moritz157/smart-buoy/README.md

# smart-buoy
Ein Jugend forscht Projekt zur Sammlung von Daten zur Gewässerqualität mit dem Ziel der Erforschung von Cyanobakterien.

### How to create the docs
`npm run buildDocs`
or
`apidoc -i ./ -o ./docs -e ./node_modules -e ./docs`
