moritz157/smart-buoy/server/database-design.png

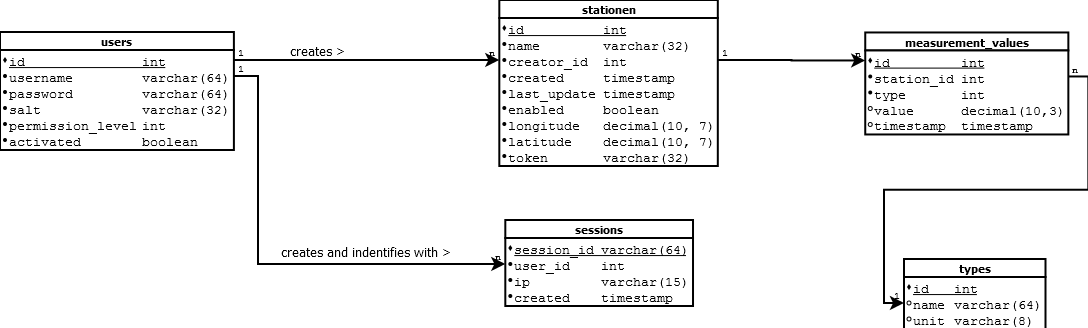
server/database-design.png
