moritz157/smart-buoy/3d models/main_case_main.3mf

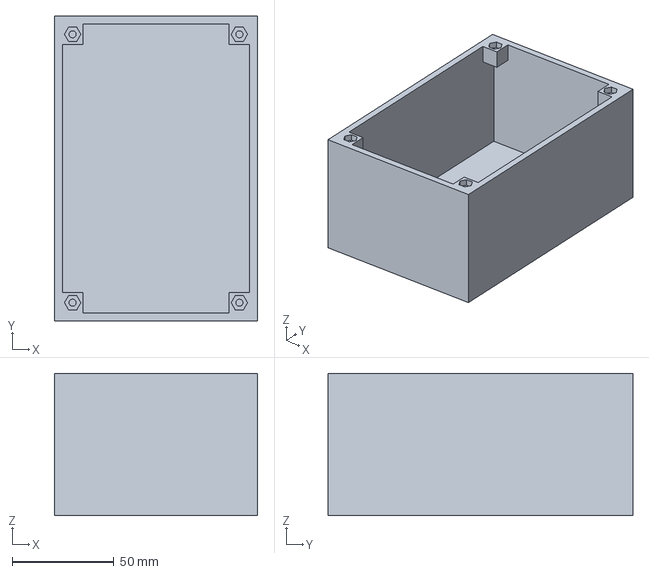
[picture p2: CAD file, 2018-02-24]
3d models/main_case_main.3mf
100.0 x 150.0 x 70.0 mm
