moritz157/smart-buoy/3d models/main_case_top.3mf

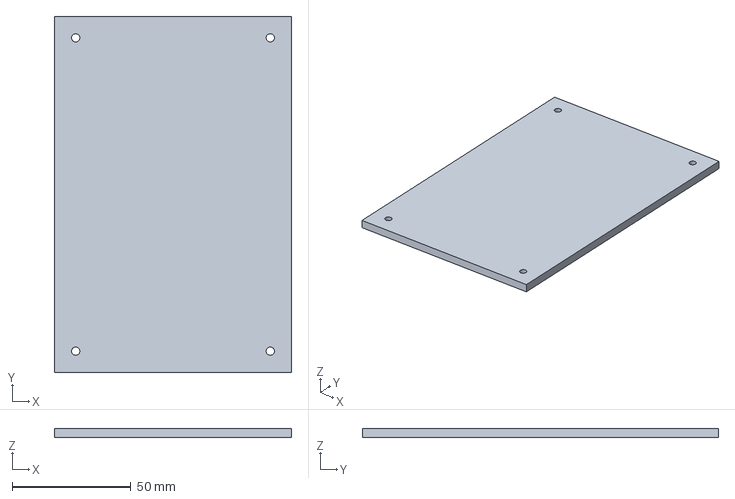
[picture p3: CAD file, 2018-02-24]
3d models/main_case_top.3mf
100.0 x 150.0 x 4.00 mm
