moritz157/smart-buoy/3d models/lamp_plate.stl

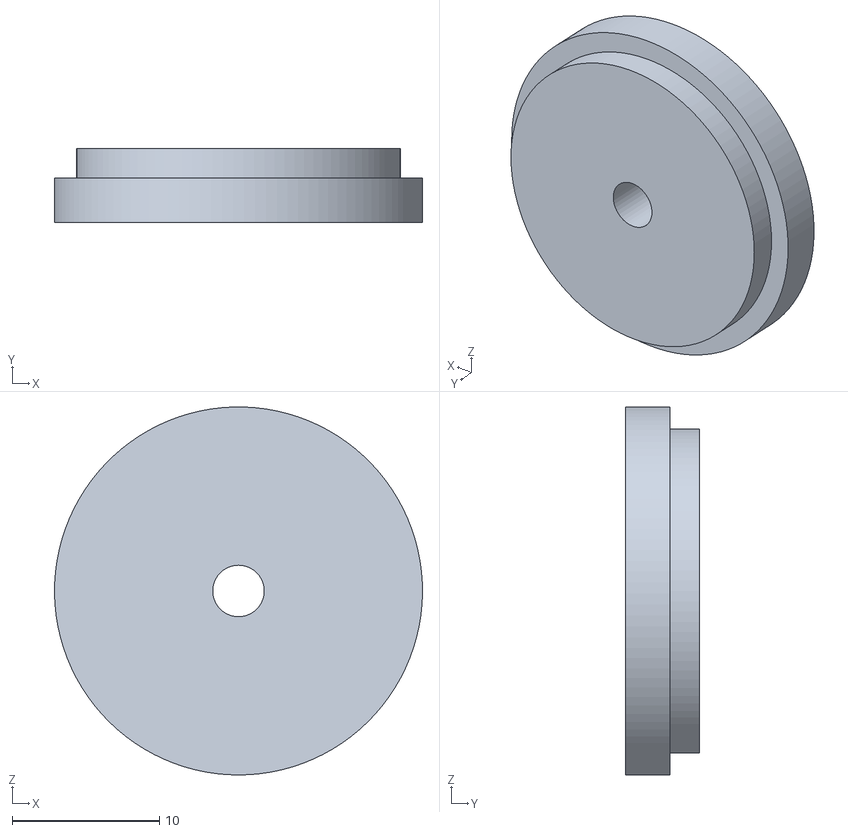
[picture p4: CAD file, 2018-02-27]
3d models/lamp_plate.stl
25.0 x 5.00 x 25.0
