moritz157/smart-buoy/3d models/lamp_case.stl

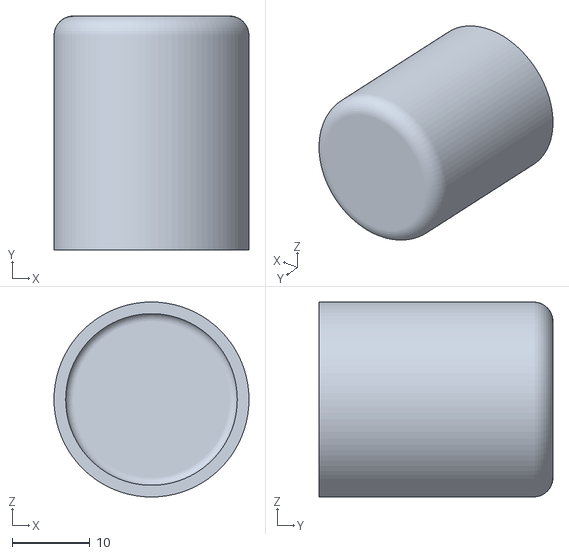
[picture p5: CAD file, 2018-02-27]
3d models/lamp_case.stl
25.0 x 30.0 x 25.0
