moritz157/smart-buoy/3d models/windrichtung/plate.stl

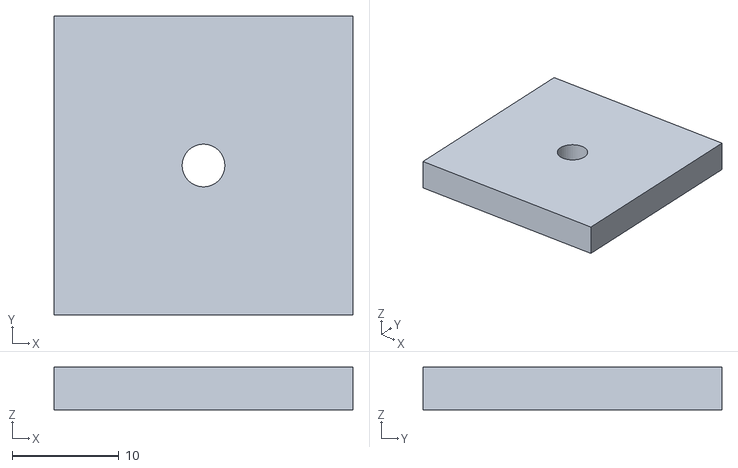
[picture p6: CAD file, 2018-02-25]
3d models/windrichtung/plate.stl
28.0 x 28.0 x 4.00
