moritz157/smart-buoy/3d models/windrichtung/weight.stl

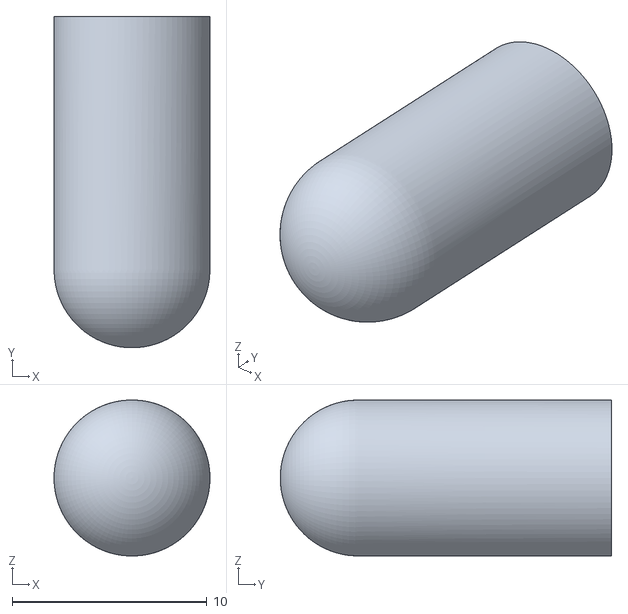
[picture p7: CAD file, 2018-02-25]
3d models/windrichtung/weight.stl
8.00 x 17.0 x 8.00
