moritz157/smart-buoy/3d models/moritz_windrichtung.3mf

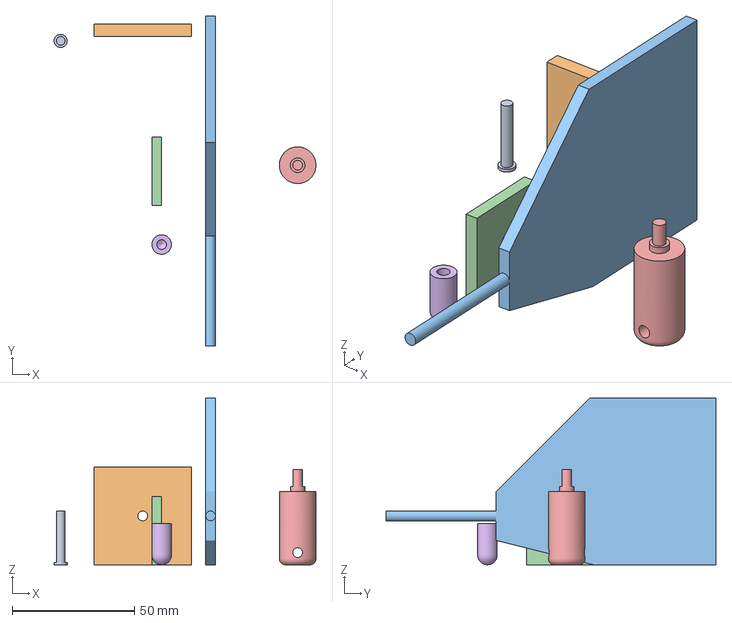
[picture p8: CAD file, 2018-02-25]
3d models/moritz_windrichtung.3mf
107.2 x 135.0 x 68.2 mm
