moritz157/smart-buoy/3d models/windrichtung/flap.stl

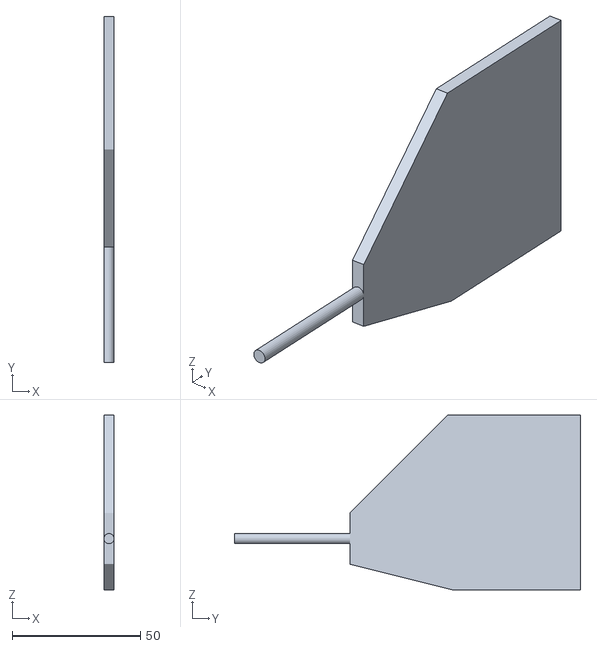
[picture p9: CAD file, 2018-02-25]
3d models/windrichtung/flap.stl
4.00 x 135.0 x 68.2
