moritz157/smart-buoy/3d models/UM2+_temp_humid_case_top_bottom.3mf

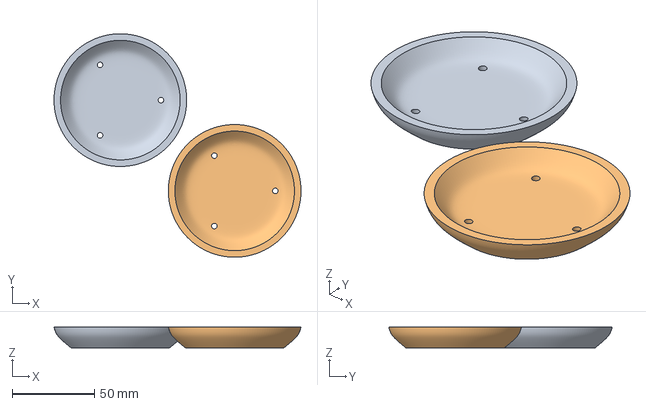
[picture p10: CAD file, 2018-02-24]
3d models/UM2+_temp_humid_case_top_bottom.3mf
150.1 x 135.7 x 12.5 mm
