moritz157/smart-buoy/3d models/moritz_anemo_plate_2.stl

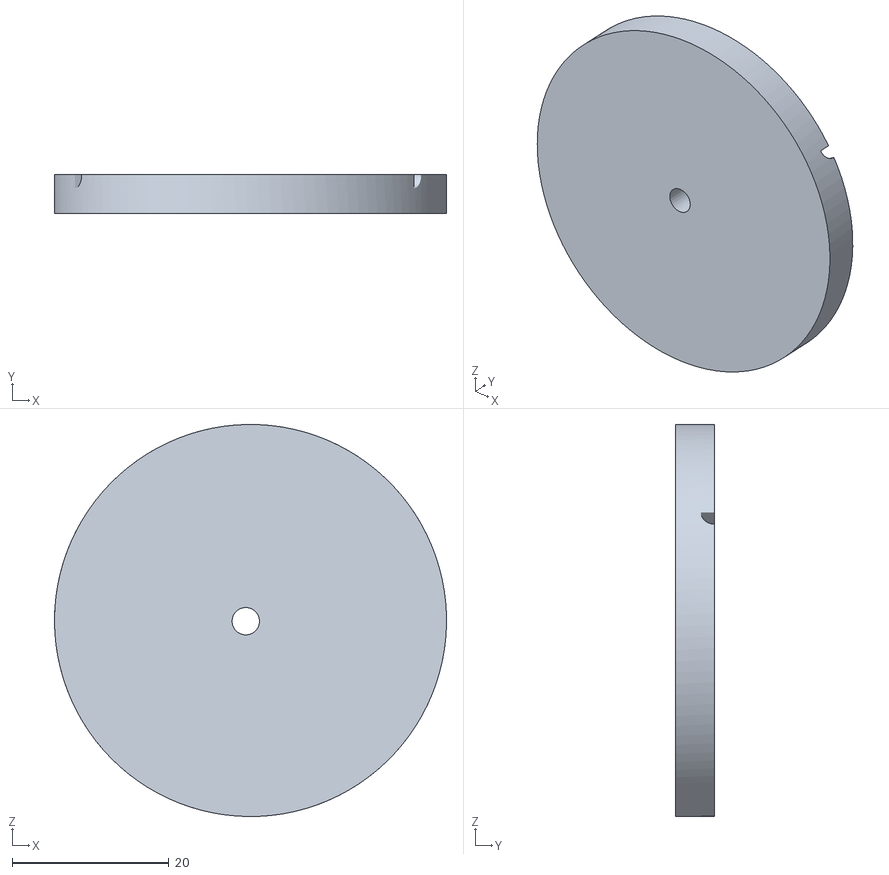
[picture p11: CAD file, 2018-02-24]
3d models/moritz_anemo_plate_2.stl
50.0 x 5.00 x 50.0
