moritz157/smart-buoy/3d models/UM2+_moritz_anemometer.3mf

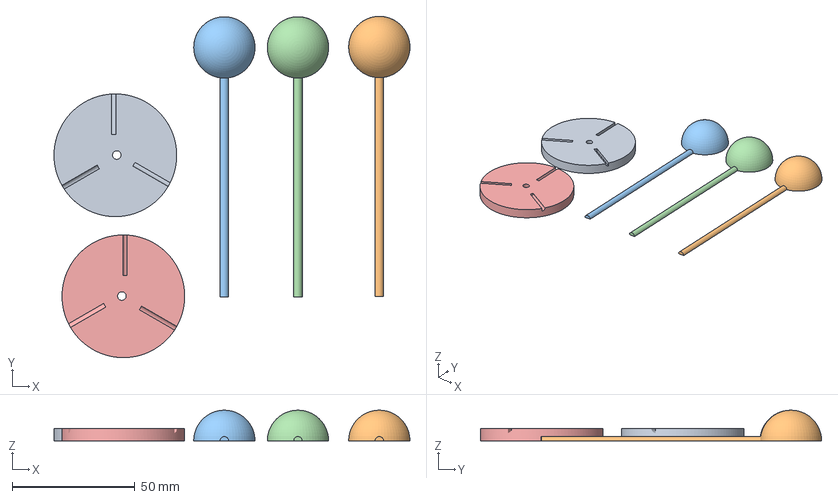
[picture p12: CAD file, 2018-02-24]
3d models/UM2+_moritz_anemometer.3mf
145.1 x 139.1 x 12.5 mm
