moritz157/smart-buoy/3d models/moritz_anemo_Schale.stl

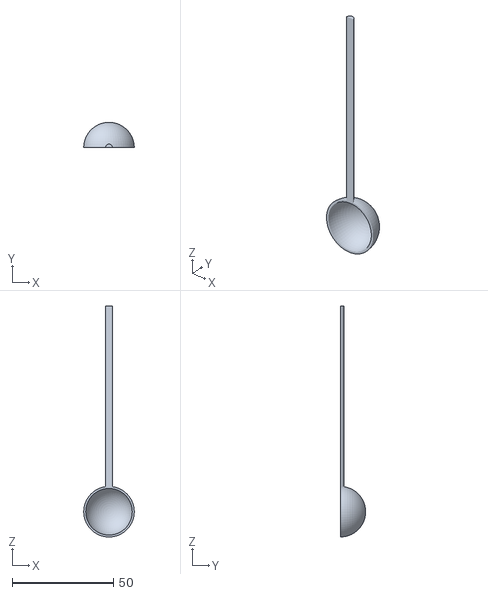
[picture p13: CAD file, 2018-02-24]
3d models/moritz_anemo_Schale.stl
25.0 x 12.5 x 114.1
