moritz157/smart-buoy/3d models/temp_humid_case_ring.stl

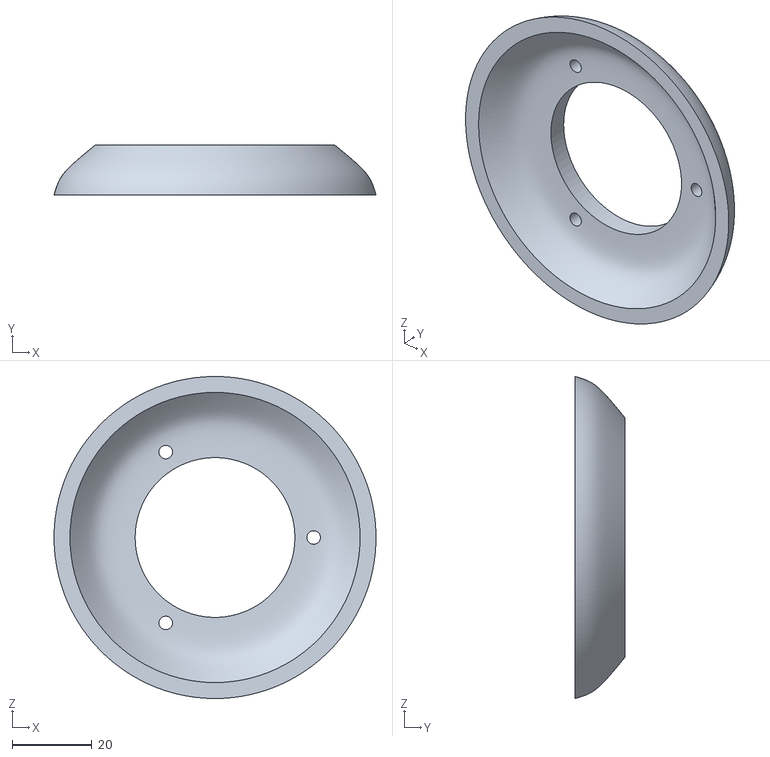
[picture p14: CAD file, 2018-02-04]
3d models/temp_humid_case_ring.stl
80.6 x 12.5 x 80.6
