moritz157/smart-buoy/3d models/windrichtung/bolt.stl

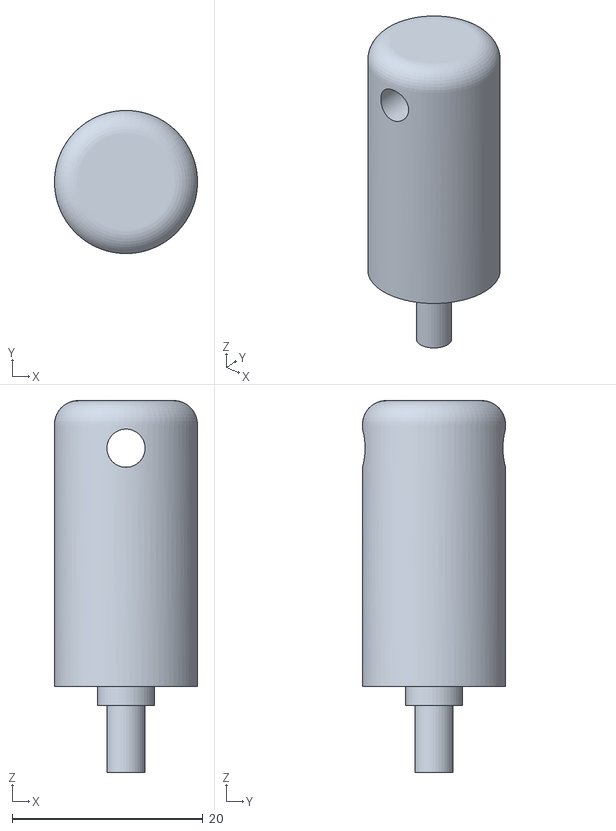
[picture p16: CAD file, 2018-02-25]
3d models/windrichtung/bolt.stl
15.0 x 15.0 x 39.0
