moritz157/smart-buoy/3d models/anemometer_bolt_plate.stl

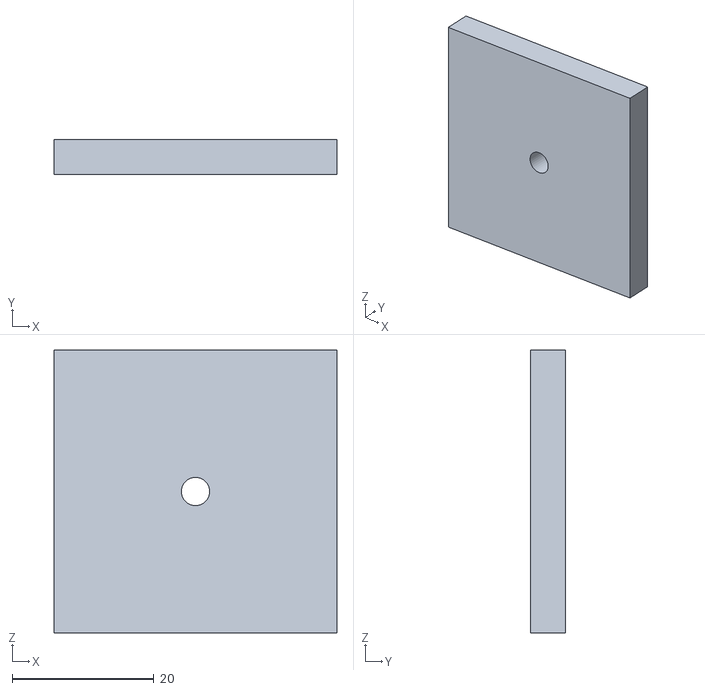
[picture p17: CAD file, 2018-02-25]
3d models/anemometer_bolt_plate.stl
40.0 x 5.00 x 40.0
