moritz157/smart-buoy/3d models/anemometer_bolt.stl

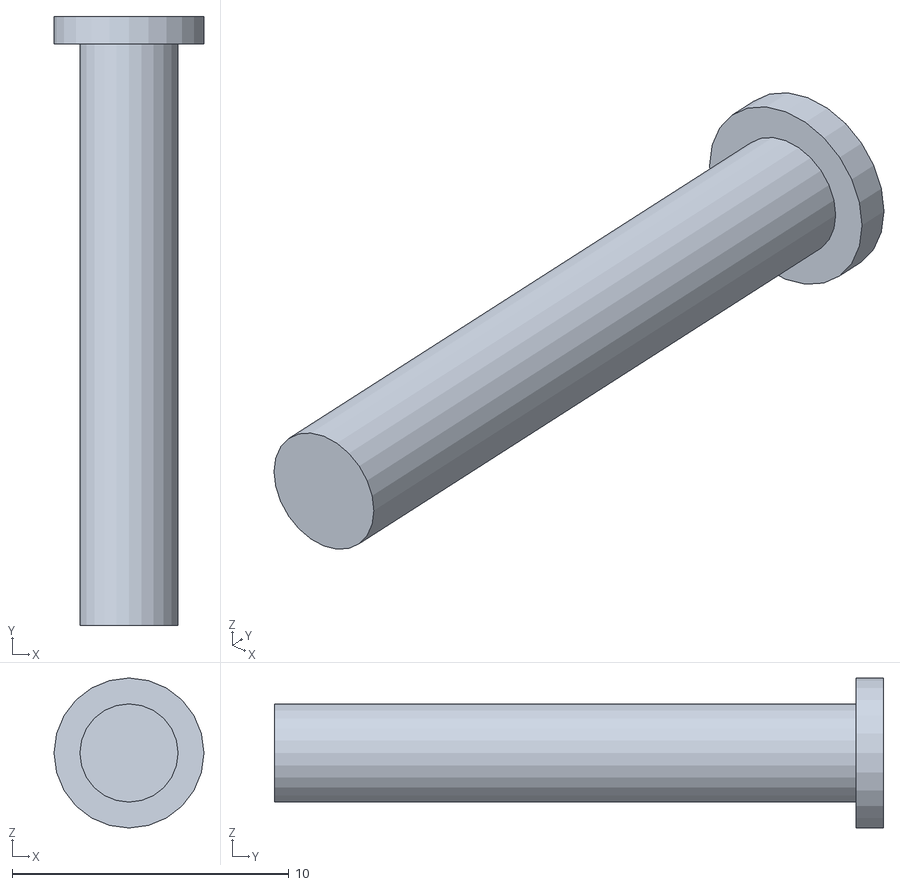
[picture p18: CAD file, 2018-02-25]
3d models/anemometer_bolt.stl
5.42 x 22.0 x 5.42
