moritz157/smart-buoy/(list of files, cad)

Other CAD files:
3d models/moritz_anemo_plate_1.stl
3d models/main_case_main.stl
3d models/main_case_top.stl
