moritz157/smart-buoy/3d models/master_assembly.png

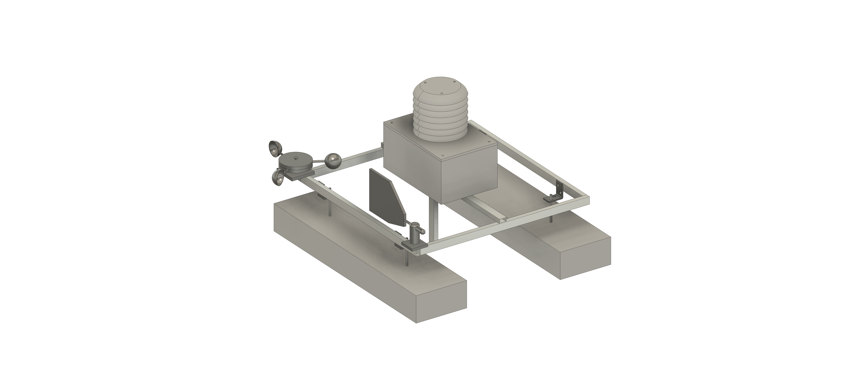
3d models/master_assembly.png
