moritz157/smart-buoy/arduino/smartbuoy/smartbuoy.ino

#include <DHT.h>
#include <DHT_U.h>

#include <OneWire.h>
#include <DallasTemperature.h>

#include <Wire.h>
#include <QMC5883L.h>

#include <SoftwareSerial.h>
#include <TinyGPS++.h>

// Data wire is plugged into pin 2 on the Arduino 
#define ONE_WIRE_BUS 2 
/********************************************************************/
// Setup a oneWire instance to communicate with any OneWire devices  
// (not just Maxim/Dallas temperature ICs) 
OneWire oneWire(ONE_WIRE_BUS); 
/********************************************************************/
// Pass our oneWire reference to Dallas Temperature. 
DallasTemperature sensors(&oneWire);
/********************************************************************/ 

//Humiditysensor
#define DHT_PIN 3
DHT dht2 = DHT(DHT_PIN, DHT11);

//Light
#define PHOTO_PIN A0
#define LIGHT_PIN 5
#define LIGHT_TRESHHOLD 155

//GPS
TinyGPSPlus gps;
SoftwareSerial softwareSerial(8, 9);

//Misc
#include <MemoryFree.h>
#include <LowPower.h>

//Compass
#define compassAddr 0x0D
//QMC5883L compass;

//SD Card
#include <SPI.h>
#include <SD.h>

//Shiftregister
#define LATCH_PIN 6
#define CLOCK_PIN 7
#define DATA_PIN 5

String bufferString;

void setup() {
  bufferString.reserve(4);
  bufferString = "";
  // put your setup code here, to run once:
  Serial.begin(9600);
  Serial.print(F("Initializing SD card..."));

  if (!SD.begin(4)) {
    Serial.println(F("initialization failed!"));
    while (1);
  }
  Serial.println(F("initialization done."));
  Serial.println(F("Temperature-sensors..."));
  sensors.begin();

  
  //DHT11
  Serial.println(F("DHT 11..."));
  dht2.begin();
  
  //LIGHT
  Serial.println(F("Light..."));
  pinMode(LIGHT_PIN, OUTPUT);
  
  //GPS
  Serial.println("GPS...");
  softwareSerial.begin(9600);
  //softwareSerial.println("$GPRMC");

  //Compass
  //compass.setReg(SET_RESET_REGISTER,0x01);
  //compass.setReg(CONTROL_REGISTER,MOD_CONTINUOUS|ODR_200HZ|RNG_2G);
  Serial.println(F("Compass..."));
  Wire.begin();
  Serial.println(F("1"));
  Wire.beginTransmission(compassAddr);
  Serial.println(F("2"));
  Wire.write(0x0B);
  Serial.println(F("3"));
  Wire.write(0x01);
  Serial.println(F("4"));
  Wire.endTransmission();
  Serial.println(F("5"));
  Wire.beginTransmission(compassAddr);
  Serial.println(F("6"));
  Wire.write(0x09);
  Serial.println(F("7"));
  Wire.write(0x01|0x03<<2|0x00<<4);
  Serial.println(F("8"));
  Wire.endTransmission();
  Serial.println(F("9"));
  /*if(!mag.begin())
  {
    Serial.println(F("Ooops, no HMC5883 detected ... Check your wiring!"));
    while(1);
  }*/

  //Serial.print("freeMemory()=");
  //Serial.println(freeMemory());
  
  //Shift register
  Serial.println(F("Shift register..."));
  pinMode(LATCH_PIN, OUTPUT);
  pinMode(CLOCK_PIN, OUTPUT);
  pinMode(DATA_PIN, OUTPUT);
  digitalWrite(LATCH_PIN, HIGH);
  Serial.println(F("Startup completed"));
}
bool saveDataToSD = true;
bool doInterval = true;
bool doSleepInterval = false;

unsigned long lastTime = 0;
unsigned long sleepingTime = 0;
unsigned long shiftTime = 0;

byte shiftRegData = 0b00001110;

void loop() {
  // put your main code here, to run repeatedly:
  //doSleepInterval = digitalRead(9);
  if(Serial.available() > 0){
    char input = Serial.read();
    bufferString+=input;
    if(input=='\r'){
      evaluateCommand(bufferString);
      bufferString="";
    }
  }
  if(doInterval && millis() - 20000 > lastTime && millis() > 20000){
    lastTime = millis();
    Serial.print(F("m|"));
    doMeasurements();
    if(doSleepInterval==true){
      sleepingTime = millis() + 5000;
    }
  }
  //Light
  //digitalWrite(LIGHT_PIN, analogRead(PHOTO_PIN)<LIGHT_TRESHHOLD);
  bitWrite(shiftRegData, 0, (analogRead(PHOTO_PIN)<LIGHT_TRESHHOLD));
  //digitalWrite(LIGHT_PIN, HIGH);
  if(millis()-300 > shiftTime){
    changeShiftRegister(shiftRegData);
    shiftTime = millis();  
  }

  //GPS
  while(softwareSerial.available() > 0){
    char c = softwareSerial.read();
    //Serial.print(c);
    gps.encode(c);
  }
  if(sleepingTime>0 && sleepingTime<millis()){
    sleepingTime=0;
    goToSleep();
  }
}

void evaluateCommand(String bufferString){
  //Serial.println(bufferString);
  if(bufferString=="a\r"){
    //Serial.print(F("freeMemory()="));
    //Serial.println(freeMemory());
    //printMagnetic();
    Serial.print(F("m|"));
    doMeasurements();
    //Serial.println(F("Did measurements"));
    //printMagnetic();
  }else if(bufferString=="i\r"){
    doInterval = !doInterval;
    Serial.println(doInterval);
  }else if(bufferString=="logSD\r"){
    printSD();
  }else if(bufferString=="sleep\r"){
    goToSleep();
  }else if(bufferString=="sensors\r"){
    Serial.println(F("sensors|DATE;TIME;HUMIDITY;AIR-TEMPERATURE;WATER-TEMPERATURE;LAT;LONG;SATELLITES;PH;WINDSPEED;HEADING;"));
  }else if(bufferString=="shift\r"){
    
    Serial.println(shiftRegData);
    //Serial.println(F("shift"));
  }
}

void doMeasurements(){
  getDateTime();
  getHumidity();
  getTemp();
  getPos();
  getPh();
  getWindspeed();
  getMagnetic();
  
  if(saveDataToSD){
    saveValueToSD(F(""), true);
  }
  Serial.println("");
  //Serial.print(F("freeMemory()="));
  //Serial.println(freeMemory());
}

void getDateTime(){
  String result = "";
  result += gps.date.value();
  //Serial.println(gps.date.value());
  result+=";";
  result+=gps.time.value();
  result+=";";
  if(saveDataToSD){
    saveValueToSD(result, false);
  }
  Serial.print(result);
  //return result;
}

void getPh(){
  String result = String(analogRead(A1));
  
  result += F(";");
  if(saveDataToSD){
    saveValueToSD(result, false);
  }
  Serial.print(result);
}

void getWindspeed() {
  unsigned long start = millis();
  int counter = 0;
  bool released = true;
  while(start+1000 > millis()){
    if(analogRead(A2)<500){
      if(released){
        counter++;
        released = false;
      }
    }else{
      released=true;
    }
  }                   //     cm/s     km/s   km/h
  float kmh = counter * 56.55 / 100000 * 3600;
  String result = String(kmh);
  result += F(";");
  if(saveDataToSD){
    saveValueToSD(result, false);
  }
  Serial.print(result);
}

void getHumidity(){
  String result = String(dht2.readHumidity());
  result += F(";");
  if(saveDataToSD){
    saveValueToSD(result, false);
  }
  Serial.print(result);
}

void getTemp(){
  sensors.requestTemperatures();
  String result = "";
  result += sensors.getTempCByIndex(1);
  result += ";";
  result += sensors.getTempCByIndex(0);
  result += ";";
  if(saveDataToSD){
    saveValueToSD(result, false);
  }
  Serial.print(result);
  //dht2.readHumidity();
  //delay(1000);
  //result += dht2.readHumidity();
  //result += ";";
  //return result;
}

void getPos(){
  //Serial.println(gps.location.lat());
  String result = "";
  result += String(gps.location.lat(), 6);
  result += ";";
  result += String(gps.location.lng(), 6);
  result += ";";
  result += String(gps.satellites.value());
  result += ";";
  if(saveDataToSD){
    saveValueToSD(result, false);
  }
  Serial.print(result);
  //return result;
}

void getMagnetic() {
  //MagnetometerRaw raw = compass.readRawAxis();
  
  //return atan2(compass.readRawAxis().YAxis, compass.readRawAxis().XAxis)*180/3.14+180;
  //return String(headingDegrees, 2);
  Wire.beginTransmission(compassAddr);
  Wire.write(0x00);
  Wire.endTransmission();

  Wire.beginTransmission(compassAddr);
  Wire.requestFrom(compassAddr, 6);

  int x, y, z;
  String result = F("");
  //Serial.println(F("Requesting mag..."));
  while(Wire.available() < 6){}
  x = Wire.read() | (Wire.read() << 8);
  y = Wire.read() | (Wire.read() << 8);
  z = Wire.read() | (Wire.read() << 8);
  result += String((atan2(y, x)*180/3.14+180), 2);
  result += F(";");
  if(saveDataToSD){
    saveValueToSD(result, false);
  }
  Serial.print(result);
}

void saveValueToSD(String sensorValue, bool nl){
  File csvFile;
  csvFile = SD.open(F("data.csv"), FILE_WRITE);
  if(csvFile){
    if(nl){
      csvFile.println(sensorValue);
    }else{
      csvFile.print(sensorValue);
    }
    csvFile.close();
  }else{
    Serial.println(F("[saveValue] Error opening data.csv"));
  }
}

void saveLineToSD(String line){
  //Serial.print(F("freeMemory()="));
  //Serial.println(freeMemory());
  //Serial.print(F("sd-line: "));
  //Serial.println(line);
  File csvFile;
  //Serial.print(F("freeMemory()="));
  //Serial.println(freeMemory());
  csvFile = SD.open(F("data.csv"), FILE_WRITE);
  if(csvFile){
    csvFile.println(line);
    csvFile.close();
  }else{
    Serial.println(F("[saveLine] Error opening data.csv"));
  }
}

void printSD(){
  File csvFile = SD.open(F("data.csv"));
  if(csvFile){
    Serial.println(F("---TRANSMISSION-START---"));
    Serial.println(F("--HEADERS--"));
    Serial.println(F("BUOY-ID=001"));
    Serial.print(F("SIZE="));
    Serial.println(csvFile.size());
    Serial.println(F("DATE;TIME;HUMIDITY;AIR-TEMPERATURE;WATER-TEMPERATURE;LAT;LONG;SATELLITES;PH;WINDSPEED;HEADING;"));
    Serial.println(F("--BODY--"));
    while(csvFile.available()){
      Serial.write(csvFile.read());
    }
    csvFile.close();
    Serial.println(F("---TRANSMISSION-END---"));
  }else{
    Serial.println(F("Error opening data.csv"));
  }
}

void goToSleep(){
  softwareSerial.end();
  Serial.println(F("Going to sleep mode..."));
  delay(40);
  LowPower.powerDown(SLEEP_8S, ADC_OFF, BOD_OFF);//   8Sec
  LowPower.powerDown(SLEEP_8S, ADC_OFF, BOD_OFF);// + 8Sec
  LowPower.powerDown(SLEEP_4S, ADC_OFF, BOD_OFF);// + 4Sec
                                                 // = 20Sec
  Serial.println(F("Woke up!"));
  softwareSerial.begin(9600);
}

void changeShiftRegister(byte shiftData){
  digitalWrite(LATCH_PIN, LOW);
  shiftOut(DATA_PIN, CLOCK_PIN, MSBFIRST, shiftData);
  digitalWrite(LATCH_PIN, HIGH);
}
