moritz157/smart-buoy/(commit log)

2017-11-26 Added a first arduino sketch + wrote a delphi program to get the data from it
2018-02-04 Added funcionality to arduino and still rearranging desktop-client
    [temp_humid_case_ring.stl, temp_humid_case_top_bottom.stl]
2018-02-24 Added some models and edited arduino code
    [UM2+_moritz_anemometer.3mf, UM2+_temp_humid_case_top_bottom.3mf, main_case_main.3mf, main_case_main.stl, main_case_top.3mf, main_case_top.stl, moritz_anemo_Schale.stl, moritz_anemo_plate_1.stl]
2018-02-24 Added models and edited arduino code
2018-02-25 Fixed website, added some models and created a poster
    [anemometer_bolt.stl, anemometer_bolt_plate.stl, bolt.stl, flap.stl, moritz_windrichtung.3mf, plate.stl, weight.stl]
2018-02-27 Midnight Backup
    [lamp_case.stl, lamp_plate.stl]
2018-02-27 Measurementtransmission from Desktop to Server (Finished #24) + Fixed realtime-refreshment
    [smartbuoy.ino]
